ARK-Electronics/ARK_Flow/README.md

# DEPRECATED

This repository is no longer maintained. Its hardware files now live in [ark-hardware/ARK_Flow](https://github.com/ARK-Electronics/ark-hardware/tree/main/ARK_Flow).

Documentation: https://docs.arkelectron.com/products/sensor/ark-flow
