ARK-Electronics/ARK_Flow/Hardware/Rev 2/ARK Flow Rev 2 BOM.xlsx

LibRef | Designator | Quantity | Manufacturer | Mfr Part Number | Comment | Mfr Part Description | Footprint | Supplier | Supplier Part Number
30007 | C1, C2, C17, C19, C20, C22, C24, C26, C29, C32, C33, C35 | 12 | Murata, Walsin Technology Corporation | GRM155R61E104KA87D, 0402X104K250CT | [NoValue], 0.1uF | CAP CER 0.1uF ±10% 25V X5R 0402 (1005 Metric) | CAP 0402/1005 | Digi-Key | 490-5920-1-ND, 1292-1640-2-ND
30151 | C3, C4, C8, C11, C12, C23, C34 | 7 | Murata | GRM155R61A225ME95D | Capacitor, [NoValue] | CAP CER 2.2uF ±20% 10V X5R 0402 (1005 Metric) | CAP 0402/1005 | Digi-Key | 490-10452-2-ND
30418 | C5, C6, C7, C9, C10, C13, C14, C15, C16, C18, C28, C30, C31 | 13 | Samsung Electro-Mechanics | CL05A106MP8NUB8 | 10uF | CAP CER 10uF ±20% 10V X5R 0402 (1005 Metric) | CAP 0402/1005 | Digi-Key | 1276-6830-1-ND
30302 | C21, C25 | 2 | TDK Corporation | C1005X5R0J475K050BC | 4.7uF | CAP CER 4.7uF ±10% 6.3V X5R 0402 (1005 Metric) | CAP 0402/1005 | Digi-Key | 445-5947-1-ND
30765 | D1 | 1 | Nexperia USA Inc. | PESD1CAN-UX | PESD1CAN-UX | TVS DIODE 24V 50V SC70-3 | SOT65P210X110-3N | Digi-Key | 1727-1306-1-ND
30943 | D2 | 1 | Lite-On Inc. | LTST-C190KRKT | LTST-C190KRKT | LED RED CLEAR CHIP SMD | LTST-C191TBKT | Digi-Key | 160-1436-2-ND
30059 | D3 | 1 | Lite-On Inc. | LTST-C191TBKT | LTST-C191TBKT | LED BLUE CLEAR 0603 SMD | LTST-C191TBKT | Digi-Key | 160-1647-1-ND
30166 | D4, D5, D6, D7 | 4 | ON Semiconductor | ESD9C3.3ST5G |  | TVS DIODE 3.3VWM SOD923 | SOD-923 | Digi-Key | ESD9C3.3ST5GOSCT-ND
30958 | D8 | 1 | Inolux | IN-P32ZTIR |  | TOP VIEW / PLCC2 / 3.5X2.8X1.9 | IN-P32ZTIR | Digi-Key | 1830-IN-P32ZTIRTR-ND
30953 | FB1 | 1 | Murata Electronics | BLM18HE152SN1D |  | FERRITE BEAD 1.5 KOHM 0603 1LN | FER 0603/1608 | Digi-Key | 490-5216-2-ND
30106 | J1, J2 | 2 | JST Sales America Inc. | SM04B-GHS-TB(LF)(SN)- |  | CONN HEADER GH SIDE 4POS 1.25MM | SM04B-GHS | Digi-Key | 455-1566-1-ND
30085 | J3 | 1 | JST Sales America Inc. | SM06B-SRSS-TB(LF)(SN) |  | CONN HEADER SH 6POS SIDE 1MM TIN | SM06B-SRSS-TB(LF)(SN) | Digi-Key | 455-1806-1-ND
30561 | Q1 | 1 | Diodes Incorporated | DMN67D7L-7 | DMN67D7L-7 | N-Channel 60V 210mA (Ta) 570mW (Ta) Surface Mount SOT-23-3 | SOT90P240X110-3N | Digi-Key | DMN67D7L-7DICT-ND
30956 | R1 | 1 | Stackpole Electronics Inc | RMCF0603FT120R | 120 | RES 120 Ohm ±1% 1/10W 0603 (1608 Metric) | RES603L | Digi-Key | RMCF0603FT120RTR-ND
30333 | R2, R3, R9, R14, R16 | 5 | Yageo | AC0402JR-07100KL | 100K | RES 100K Ohm ±5% 1/16W 0402 (1005 Metric) | RESC0402(1005)_N | Digi-Key | YAG3515CT-ND
30327 | R4, R6, R10, R13, R15, R17 | 6 | Yageo | AC0402JR-070RL | 0 | RES 0 Ohm Jumper 1/16W 0402 (1005 Metric) | RESC0402(1005)_N | Digi-Key | 311-0.0LBCT-ND
30610 | R5 | 1 | Yageo | RC0402FR-0782KL | 82K | RES 82K Ohm ±1% 1/16W 0402 (1005 Metric) | RESC0402(1005)_N | Digi-Key | 311-82.0KLRCT-ND
30800 | R7 | 1 | Yageo | RC0402FR-0718K2L | 18.2K | RES 18.2K Ohm ±1% 1/16W 0402 (1005 Metric) | RESC0402(1005)_N | Digi-Key | YAG2371CT-ND
30207 | R8 | 1 | Yageo | RC0402FR-075K1L |  | RES 5.1K Ohm ±1% 1/16W 0402 (1005 Metric) | RESC0402(1005)_N | Digi-Key | 311-5.10KLRCT-ND
30054 | R11 | 1 | Yageo | RC0402FR-072K2L | Resistor | RES 2.2K Ohm ±1% 1/16W 0402 (1005 Metric) | RESC0402(1005)_N | Digi-Key | 311-2.20KLRCT-ND
30457 | R12 | 1 | Stackpole Electronics Inc | RMCF0402FT1K50 | 1.5K | RES 1.5K Ohm ±1% 1/16W 0402 (1005 Metric) | RESC0402(1005)_N | Digi-Key | RMCF0402FT1K50CT-ND
30959 | R19 | 1 | Stackpole Electronics Inc | RMCF1206FG71R5 | 71.5 | RES 71.5 Ohm ±1% 0.25W, 1/4W 1206 (3216 Metric) | RESC3216X04N | Digi-Key | RMCF1206FG71R5TR-ND
30095 | U1 | 1 | NXP USA Inc. | TJA1051TK/3,118 | TJA1051TK/3,118 | IC CAN TRANSEIVER HS 8HVSON | 8DFN_3x3 | Digi-Key | 568-8686-1-ND
30604 | U2 | 1 | Monolithic Power Systems Inc. | MPM3811GG-Z | MPM3811GG-Z | Non-Isolated PoL Module DC DC Converter 1 Output 0.6 ~ 1.2V 1A 2.3V - 5.5V Input | MPM3804 | Digi-Key | 1589-1958-1-ND
30951 | U3 | 1 | Texas Instruments | LM66100DCKR |  | IC OR CTRLR IDEAL DIODE SC70-6 | SOT65P210X110-6N | Digi-Key | 296-53541-2-ND
30955 | U4 | 1 | Toshiba Semiconductor and Storage | TCR3UF20A,LM(CT |  | (LDO) REG, VOUT: 2.0V IOUT: 300M | DIODES SOT25 | Digi-Key | 264-TCR3UF20ALM(TR-ND
30954 | U5 | 1 | Pixart | PAW3902JF-TXQT |  | Sensor_Optical Sensor_Lighting Sensor | PQFN65P500X500X236_HS-15N | WPG | PAW3902JF-TXQT
30579 | U6 | 1 | STMicroelectronics | STM32F412CEU6 | STM32F412CEU6 | ARM® Cortex®-M4 STM32F4 Microcontroller IC 32-Bit 100MHz 512KB (512K x 8) FLASH 48-UFQFPN (7x7) | UFQFPN48 | Digi-Key | 497-18545-ND
31087 | U7 | 1 | IQD Frequency Products | LFSPXO072801REEL | LFSPXO072801REEL | XTAL OSC XO 8.0000MHZ HCMOS SMD | LFSPXO072801REEL | Digi-Key | 1923-1681-2-ND
30952 | U8 | 1 | Broadcom Limited | AFBR-S50LV85D |  | 850NM LONGRANGE 1D TOF SENSOR | AFBR-S50LV85D | Digi-Key | 516-AFBR-S50LV85D-ND
31021 | U9 | 1 | TDK InvenSense | ICM-42688-P | ICM-42688-P | MOTION SENSOR | ICM-42688-P | Digi-Key | 1428-ICM-42688-PTR-ND
