ARK-Electronics/ARK_Flow/Case/Top Case Rev 1.stl

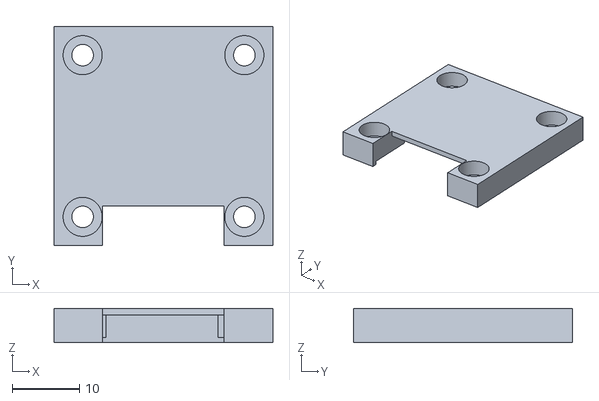
[picture p1: CAD file, 2021-06-14]
Case/Top Case Rev 1.stl
32.5 x 32.5 x 5.06
