ARK-Electronics/ARK_Flow/Case/Bottom Case Rev 1.stl

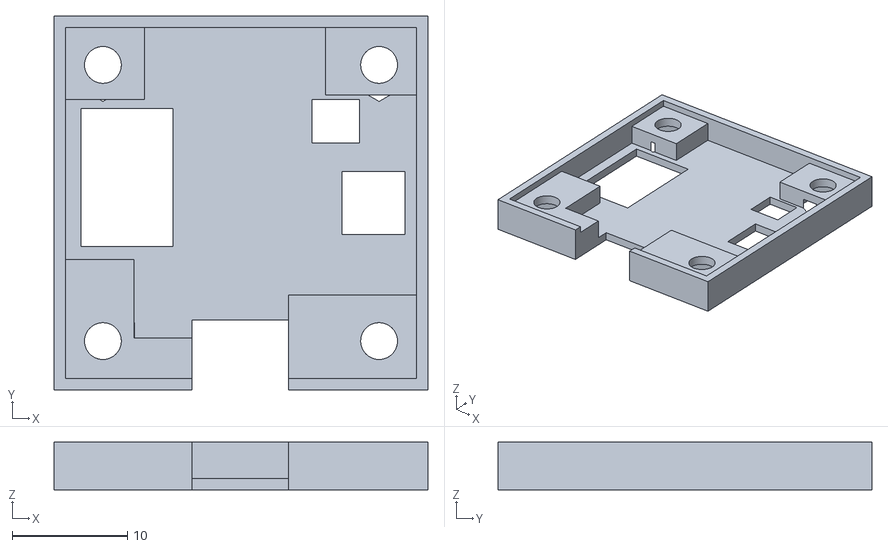
[picture p2: CAD file, 2021-06-14]
Case/Bottom Case Rev 1.stl
32.5 x 32.5 x 4.16
