ARK-Electronics/ARK_Flow/Hardware/Rev 2/ARK Flow Rev 2 Schematic.PDF

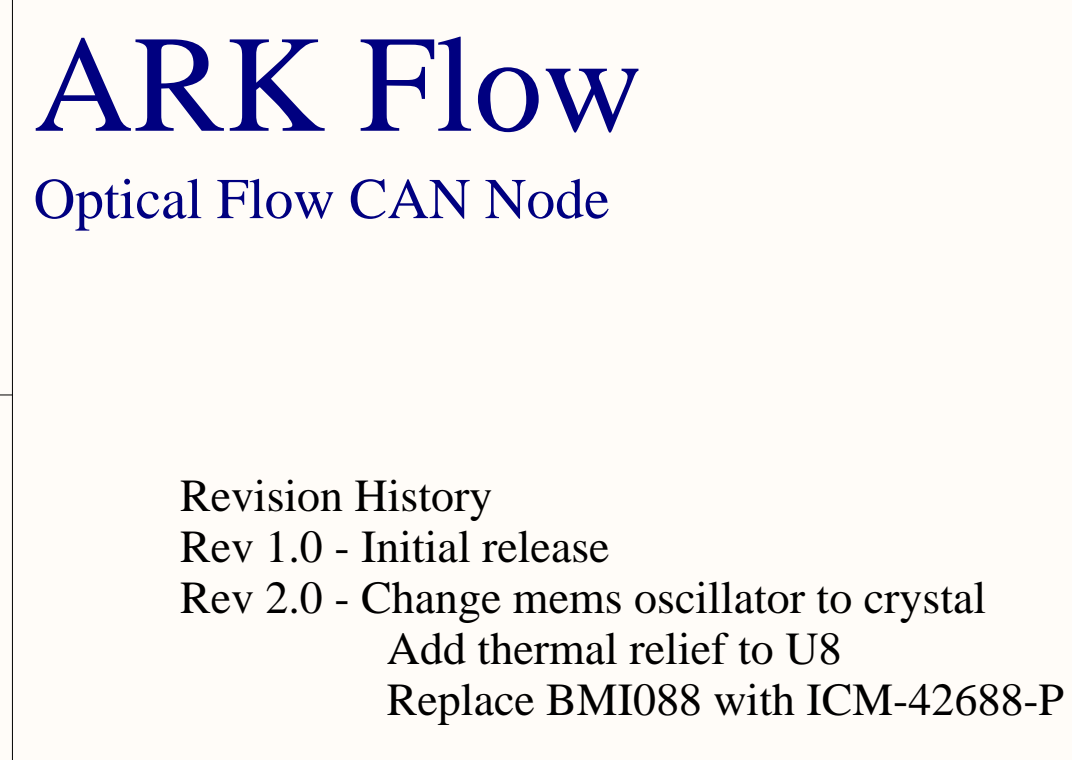
[picture p3: page 1]

Optical Flow CAN Node

Revision History
Rev 1.0 - Initial release
Rev 2.0 - Change mems oscillator to crystal

Add thermal relief to U8
Replace BMI088 with ICM-42688-P

Revision: 2.0 | Variant: Production

Date: 6/28/2021 | Time: 3:11:07 PM | Size: LEGAL | Sheet 1 of 3

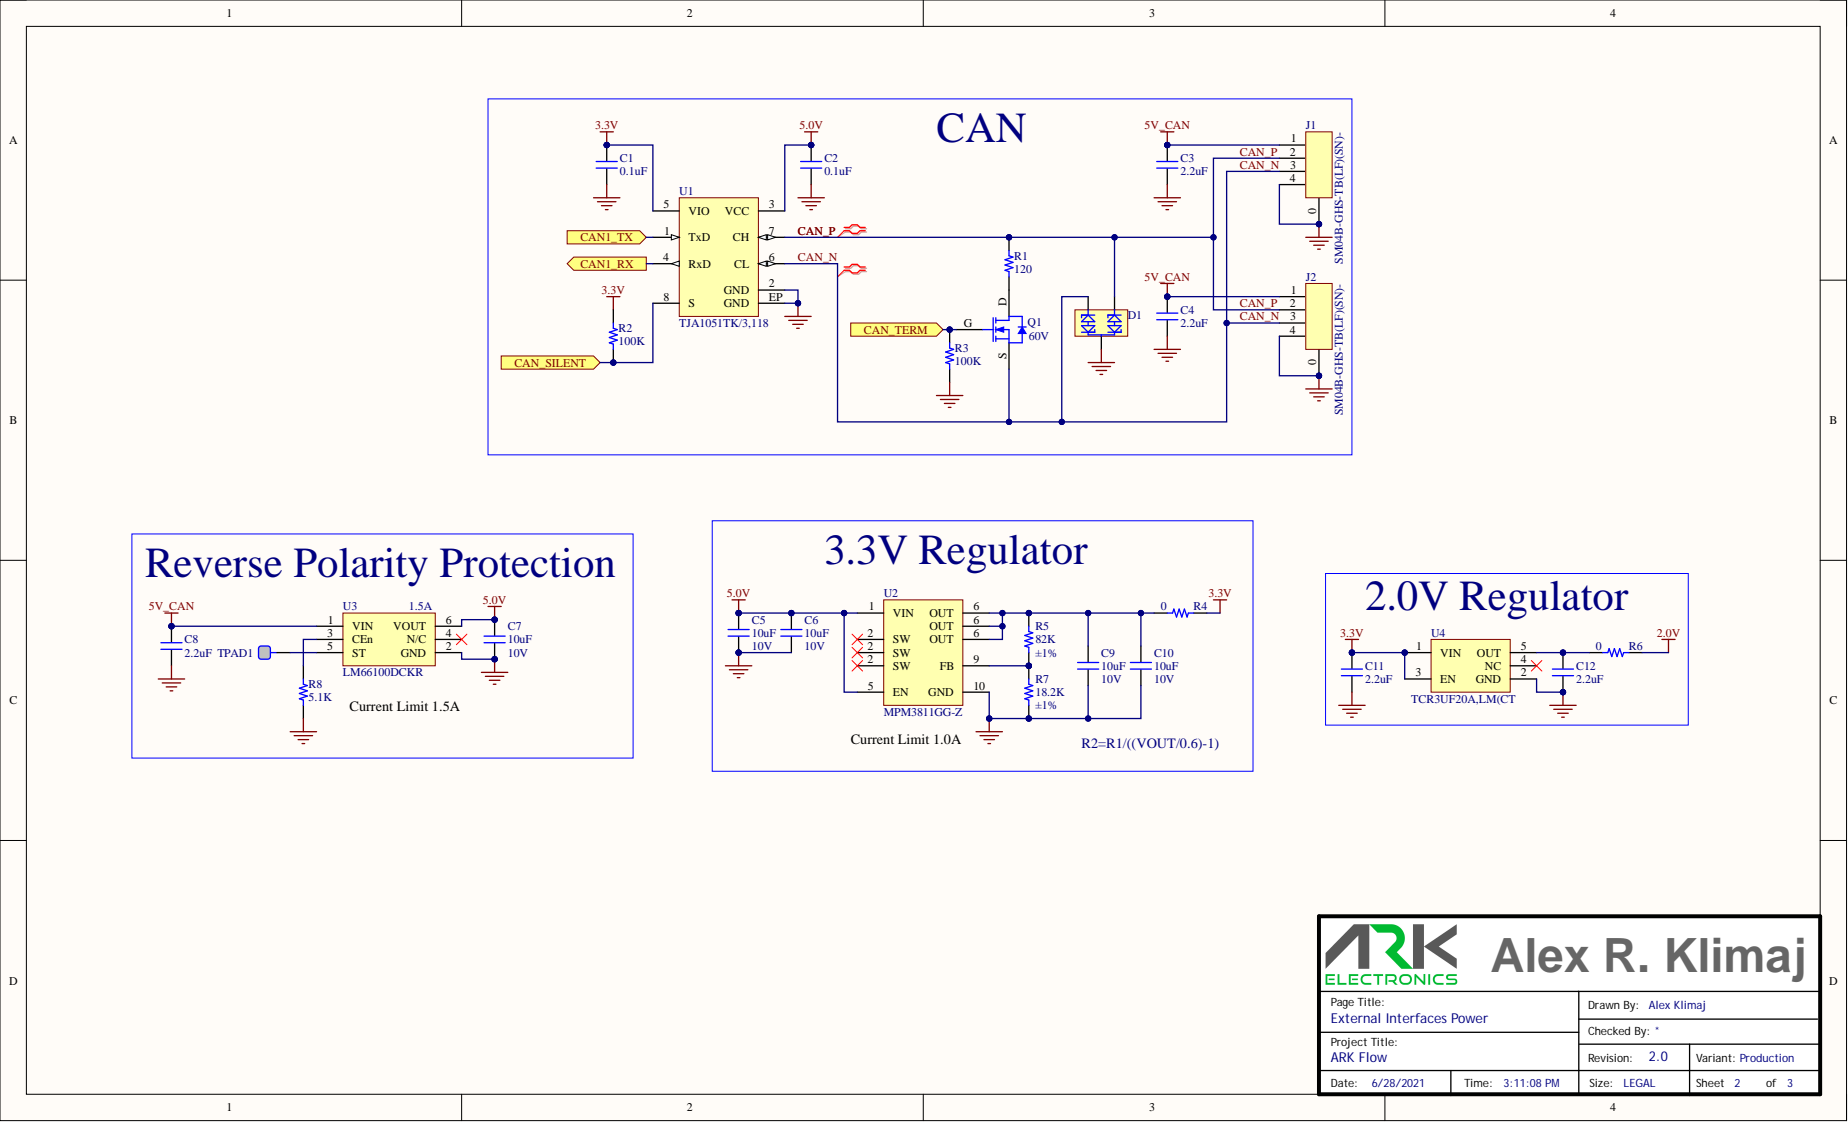
[picture p4: page 2]

SM04B-GHS-TB(LF)(SN)-

CAN_N | 3

Revision: 2.0 | Variant: Production

Date: 6/28/2021 | Time: 3:11:08 PM | Size: LEGAL | Sheet 2 of 3

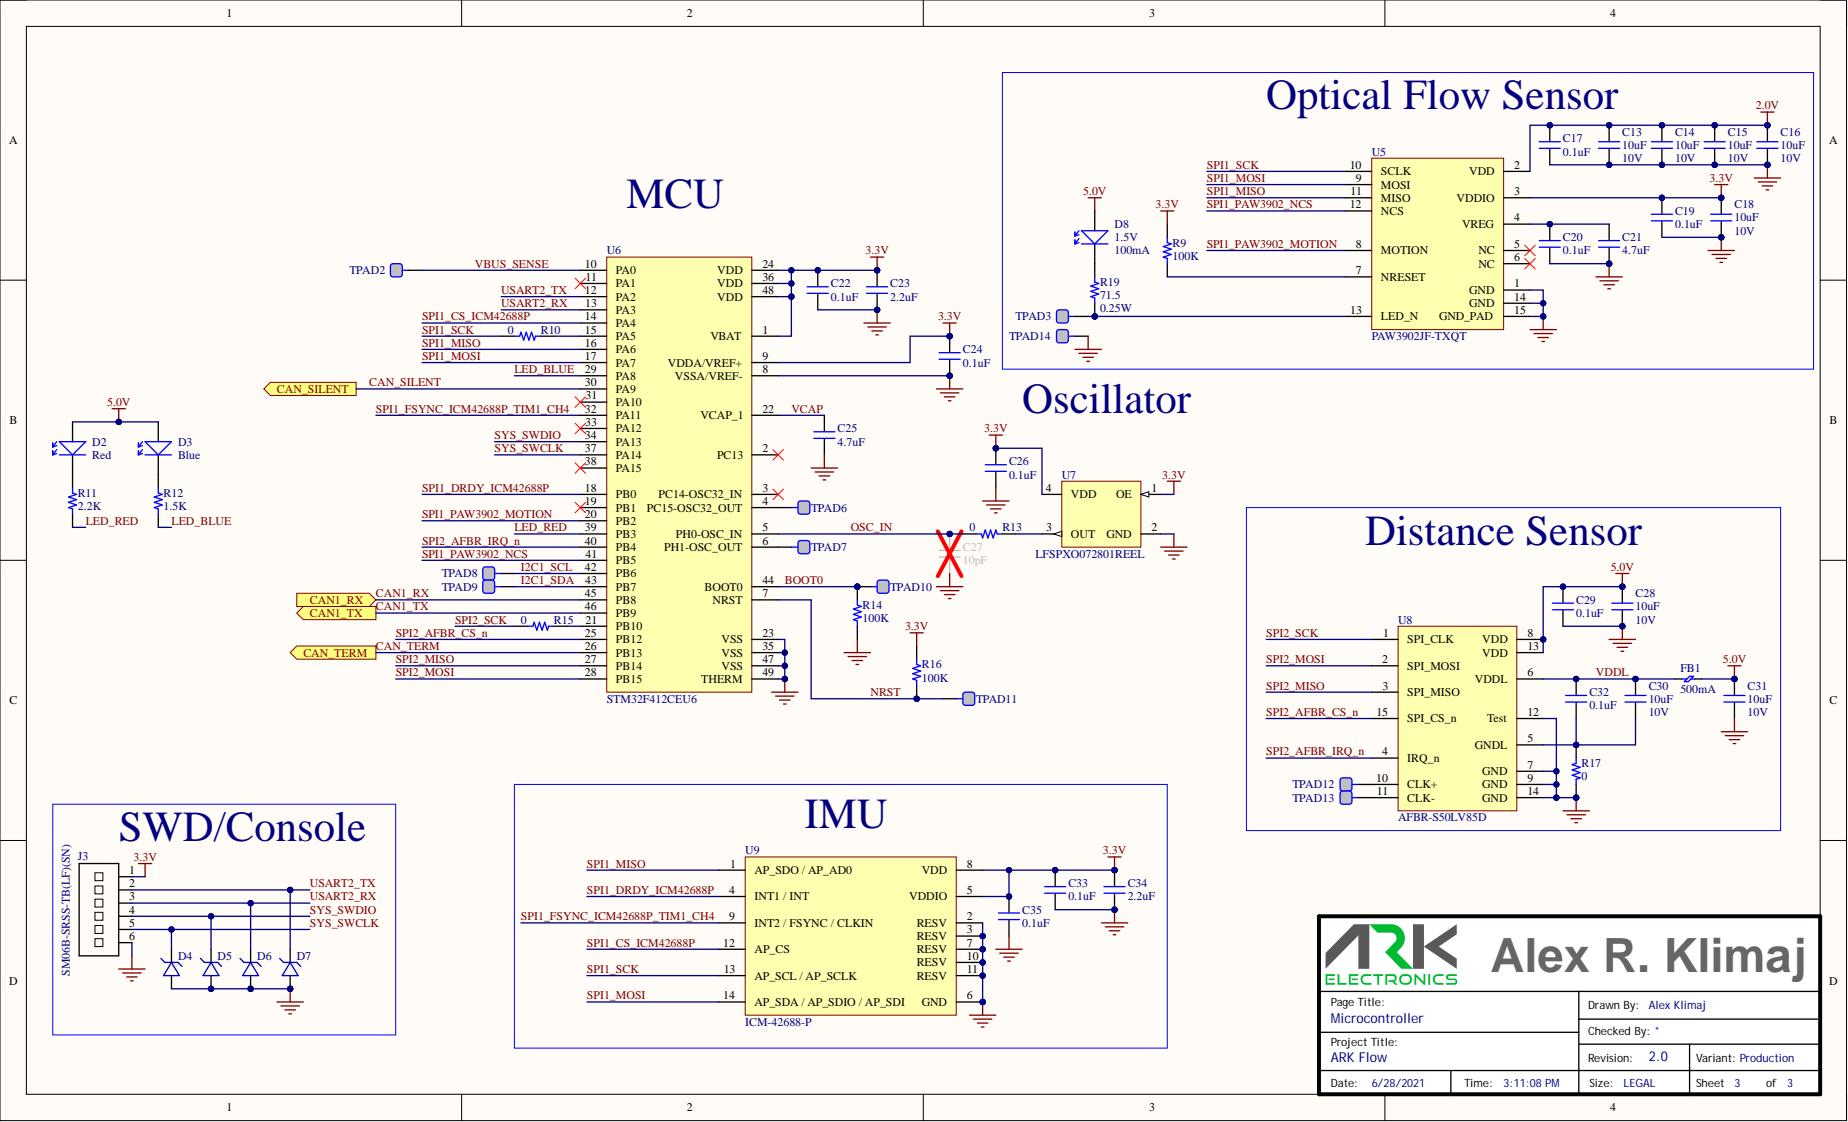
[picture p5: page 3]

SM06B-SRSS-TB(LF)(SN) J3

Revision : 2. | Variant : Producti o n

Date : 6/28/2021 | Time: 3:11:08 PM | Size : LEGA L | Sheet of
