ARK-Electronics/ARK_Flow/Hardware/Rev 1/ARK Flow Rev 1 Schematic.PDF

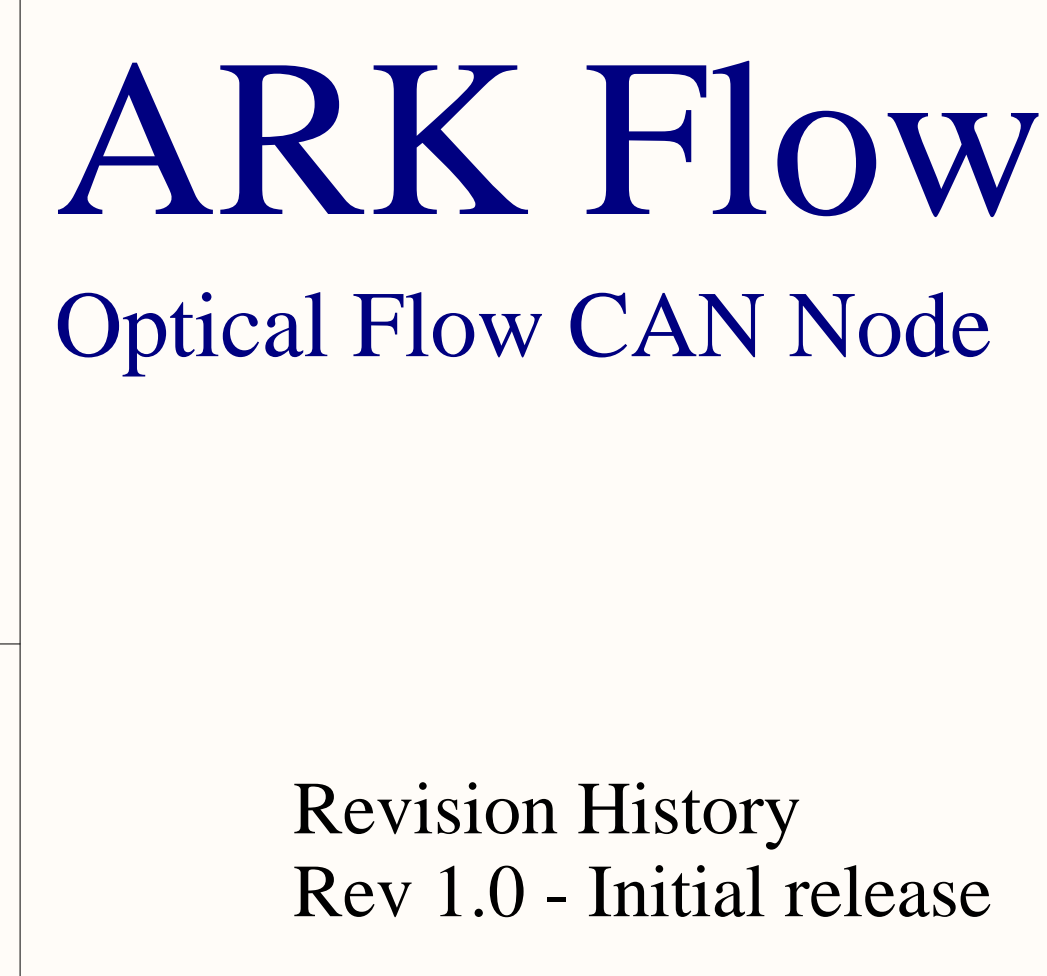
[picture p6: page 1]

Optical Flow CAN Node

Revision: 1.0 | Variant: Production

Date: 12/23/2020 | Time: 9:05:49 PM | Size: LEGAL | Sheet 1 of 3

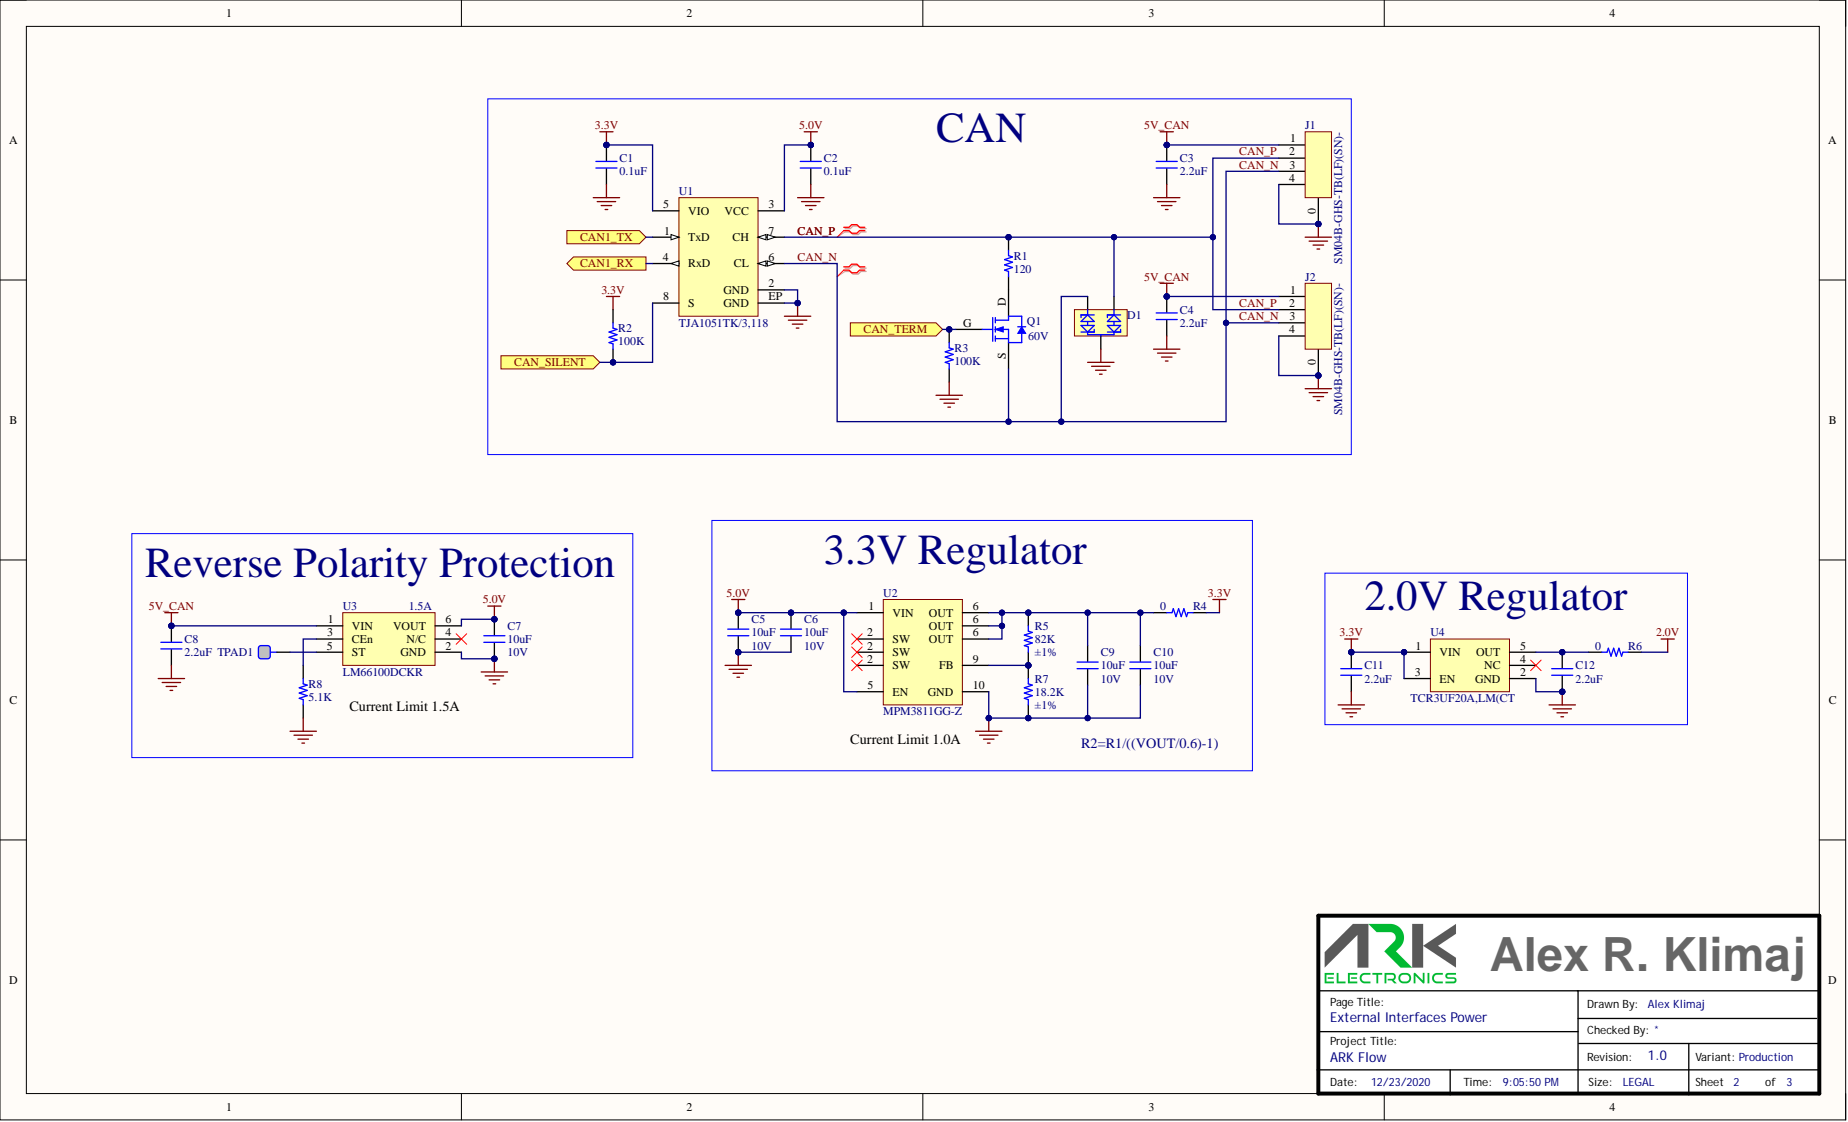
[picture p7: page 2]

SM04B-GHS-TB(LF)(SN)-

CAN_N | 3

Revision: 1.0 | Variant: Production

Date: 12/23/2020 | Time: 9:05:50 PM | Size: LEGAL | Sheet 2 of 3

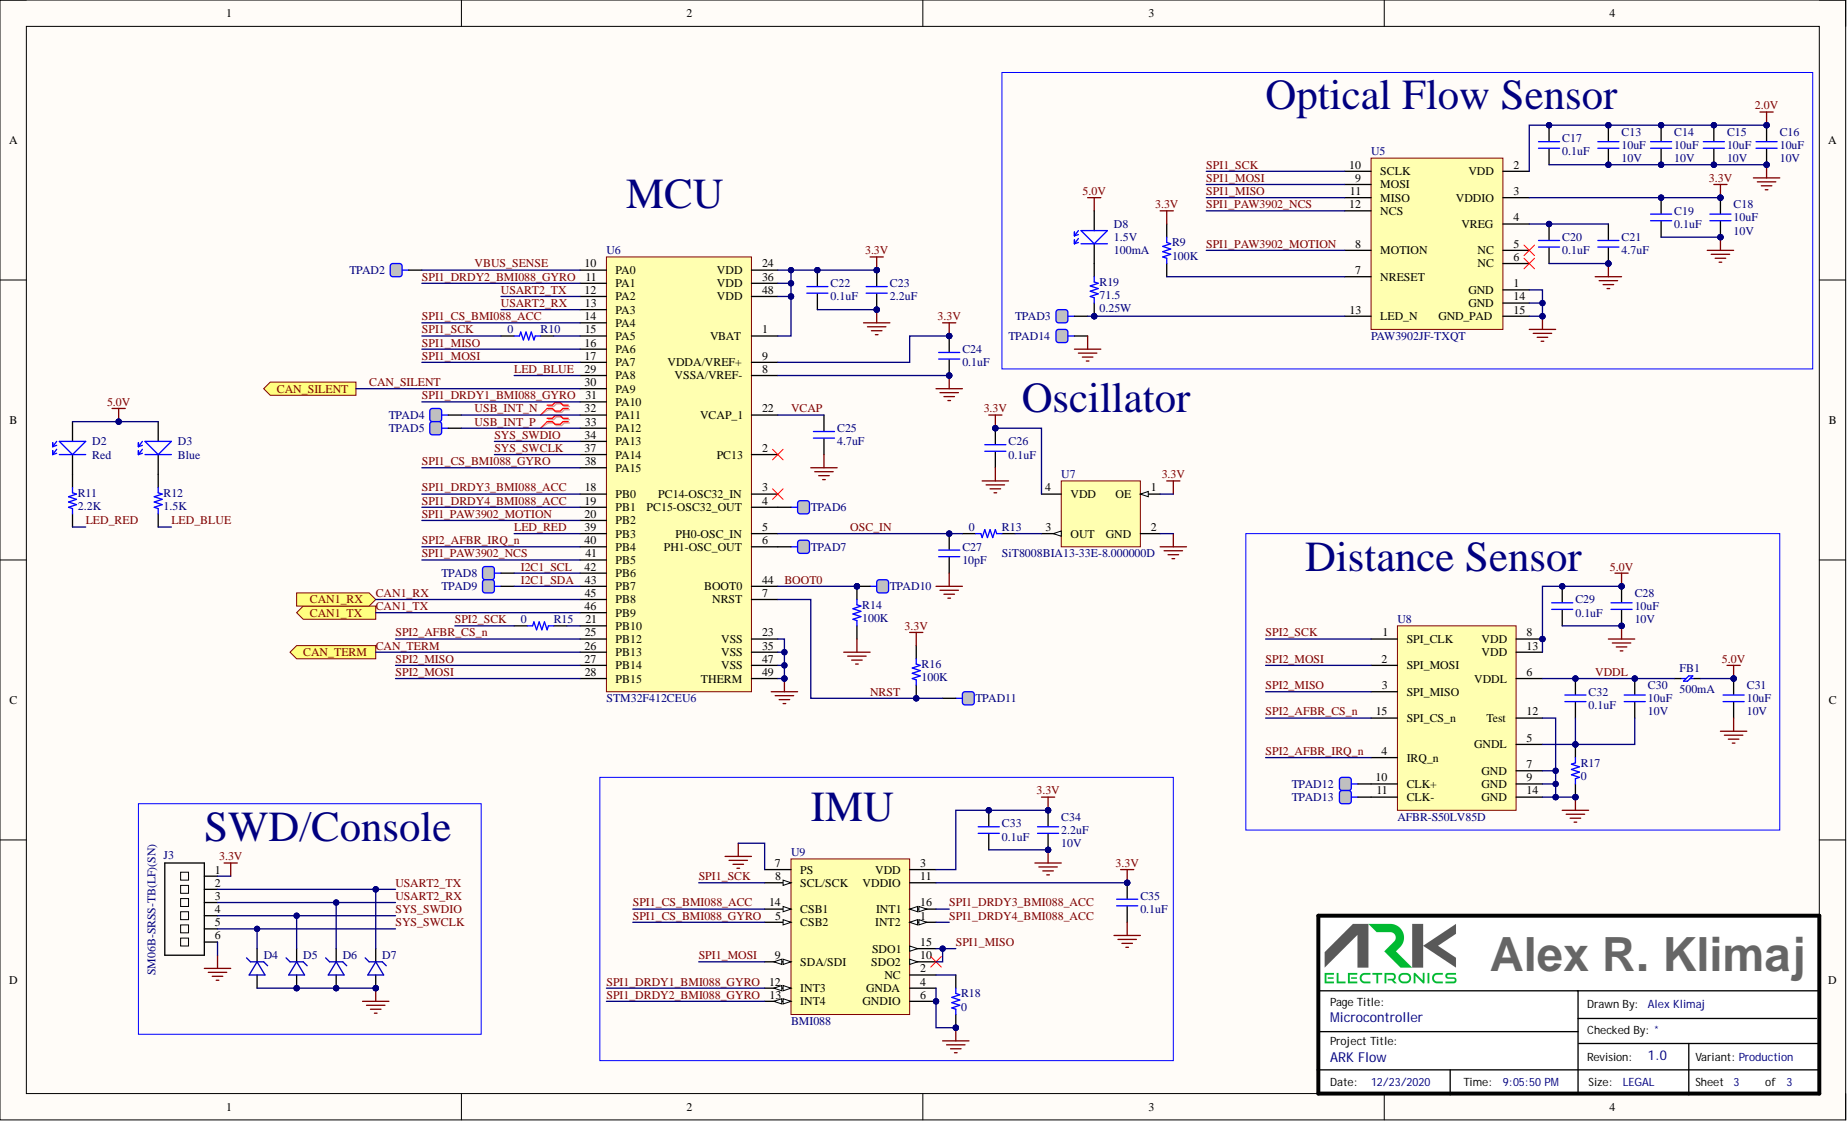
[picture p8: page 3]

SM06B-SRSS-TB(LF)(SN) J3

Revision : 1. | Variant : Producti o n

Date : 12/23/2020 | Time: 9:05:50 PM | Size : LEGA L | Sheet of
