ARK-Electronics/ARK_Flow/(commit log)

2020-12-23 Create ARK Flow Rev 1 Schematic.PDF
2020-12-23 Update ARK Flow Rev 1 Schematic.PDF
2020-12-24 Update rev 1 docs
    [ARK Flow Rev 1 BOM.xlsx]
2021-06-14 Add Rev 2 and Case
    [ARK Flow Rev 2 BOM.xlsx, Bottom Case Rev 1.stl, Top Case Rev 1.stl]
2021-06-28 Update Rev 2 Files
    [ARK Flow Rev 2 BOM.xlsx]
2022-01-03 Create ARK Flow Rev 2 3D Model With FOV.step
2022-01-03 Update ARK Flow Rev 2 3D Model With FOV.step
